lacduong/TacLeg/README.md

# Open-Source 3-D Design of a Tactile Sensory Below-Knee Leg Prosthesis

The letter "TacLeg: A Novel Visuotactile Device for Below-Knee Leg Prostheses" was published in IEEE Robotics and Automation Letters

https://ieeexplore.ieee.org/document/10621588

# Contact for support

Dr. Duong Van Lac

Email: duonglacbk@gmail.com or lac.duongvan@hust.edu.vn

# Please cite the original letter

L. V. Duong, "TacLeg: A Novel Visuotactile Device for Below-Knee Leg Prostheses," in IEEE Robotics and Automation Letters, vol. 9, no. 9, pp. 8027-8034, Sept. 2024, doi: 10.1109/LRA.2024.3438038
