lacduong/TacLeg/TacLegSensingPart.stp

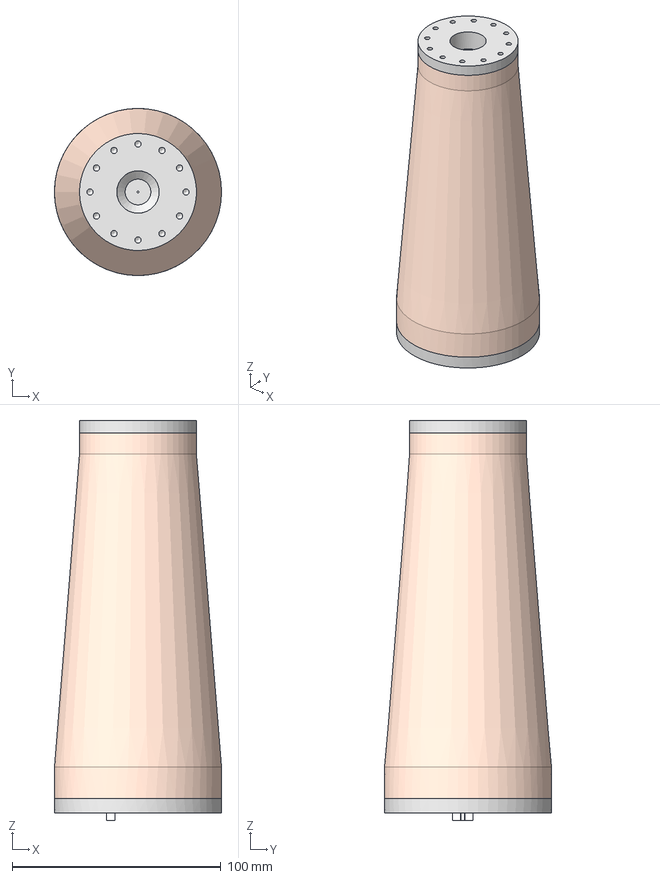
[picture p1: CAD file, 2024-06-23]
TacLegSensingPart.stp
80.0 x 80.0 x 191.5 mm
NutJoint
ProstheticSkin
Tube
Camera
NutJoint_1
LED 3mm Red x 24
ISO 7045 - M2.5 x 5 - 4.8 - Z x 4
